jamesguitar3/sparkpal/(threads)

Thread 2 (2022-01-10):

Compiling error - fixed

gamemaster84, 2022-01-10:
Hi, When i compile i get an issue:

Arduino:1.8.15 (Windows 10), TD: 1.54, Board:"DOIT ESP32 DEVKIT V1, 80MHz, 921600, None"

sketch\sparkpal.ino.cpp.o:(.literal._Z6initBTv+0x14): undefined reference to `BluetoothSerial::register_callback(void (*)(esp_spp_cb_event_t, esp_spp_cb_param_t*))'

sketch\sparkpal.ino.cpp.o:(.literal._Z6initBTv+0x18): undefined reference to `BluetoothSerial::begin(String, bool)'

sketch\sparkpal.ino.cpp.o:(.literal.startup._GLOBAL__sub_I_SET_PRESET_1_CMD+0x24): undefined reference to `BluetoothSerial::BluetoothSerial()'

sketch\sparkpal.ino.cpp.o:(.literal._Z16sendSetPresetCmdPh+0x0): undefined reference to `BluetoothSerial::write(unsigned char const*, unsigned int)'

sketch\sparkpal.ino.cpp.o:(.literal._Z12connectToAmpv+0x14): undefined reference to `BluetoothSerial::connect(String)'

sketch\sparkpal.ino.cpp.o:(.literal._Z12connectToAmpv+0x18): undefined reference to `BluetoothSerial::hasClient()'

sketch\sparkpal.ino.cpp.o:(.literal._Z16processRecBTDatah+0x10): undefined reference to `BluetoothSerial::available()'

sketch\sparkpal.ino.cpp.o:(.literal._Z4loopv+0x0): undefined reference to `BluetoothSerial::read()'

sketch\sparkpal.ino.cpp.o:(.literal.exit._GLOBAL__sub_D_SET_PRESET_1_CMD+0x0): undefined reference to `BluetoothSerial::~BluetoothSerial()'

sketch\sparkpal.ino.cpp.o: In function `initBT()':

sparkpal/sparkpal.ino:224: undefined reference to `BluetoothSerial::register_callback(void (*)(esp_spp_cb_event_t, esp_spp_cb_param_t*))'

sparkpal/sparkpal.ino:225: undefined reference to `BluetoothSerial::begin(String, bool)'

sketch\sparkpal.ino.cpp.o: In function `_GLOBAL__sub_I_SET_PRESET_1_CMD':

\sparkpal/sparkpal.ino:31: undefined reference to `BluetoothSerial::BluetoothSerial()'

sketch\sparkpal.ino.cpp.o: In function `MatchState::MatchState()':

\Arduino\libraries\Regexp\src/Regexp.h:79: undefined reference to `BluetoothSerial::write(unsigned char const*, unsigned int)'

sketch\sparkpal.ino.cpp.o: In function `btnPresetHandler(BfButton*, BfButton::press_pattern_t)':

sparkpal/sparkpal.ino:114: undefined reference to `BluetoothSerial::write(unsigned char const*, unsigned int)'

sketch\sparkpal.ino.cpp.o: In function `sendFXOnOffCmd(int, int)':

sparkpal/sparkpal.ino:197: undefined reference to `BluetoothSerial::write(unsigned char const*, unsigned int)'

sketch\sparkpal.ino.cpp.o: In function `connectToAmp()':

sparkpal/sparkpal.ino:238: undefined reference to `BluetoothSerial::connect(String)'

sparkpal/sparkpal.ino:239: undefined reference to `BluetoothSerial::hasClient()'

sparkpal/sparkpal.ino:246: undefined reference to `BluetoothSerial::write(unsigned char const*, unsigned int)'

sketch\sparkpal.ino.cpp.o: In function `processRecBTData(unsigned char)':

sparkpal/sparkpal.ino:383: undefined reference to `BluetoothSerial::available()'

sparkpal/sparkpal.ino:429: undefined reference to `BluetoothSerial::write(unsigned char const*, unsigned int)'

sketch\sparkpal.ino.cpp.o: In function `loop()':

sparkpal/sparkpal.ino:479: undefined reference to `BluetoothSerial::available()'

sparkpal/sparkpal.ino:480: undefined reference to `BluetoothSerial::read()'

sketch\sparkpal.ino.cpp.o: In function `_GLOBAL__sub_D_SET_PRESET_1_CMD':

sparkpal/sparkpal.ino:483: undefined reference to `BluetoothSerial::~BluetoothSerial()'

collect2.exe: error: ld returned 1 exit status

exit status 1

Fout bij het compileren voor board DOIT ESP32 DEVKIT V1

Can you help out please?

Joost

Closed 2022-01-11.
