jamesguitar3/sparkpal/assets/SparkPal -esp32_wiring.pdf

## GND

## esp32

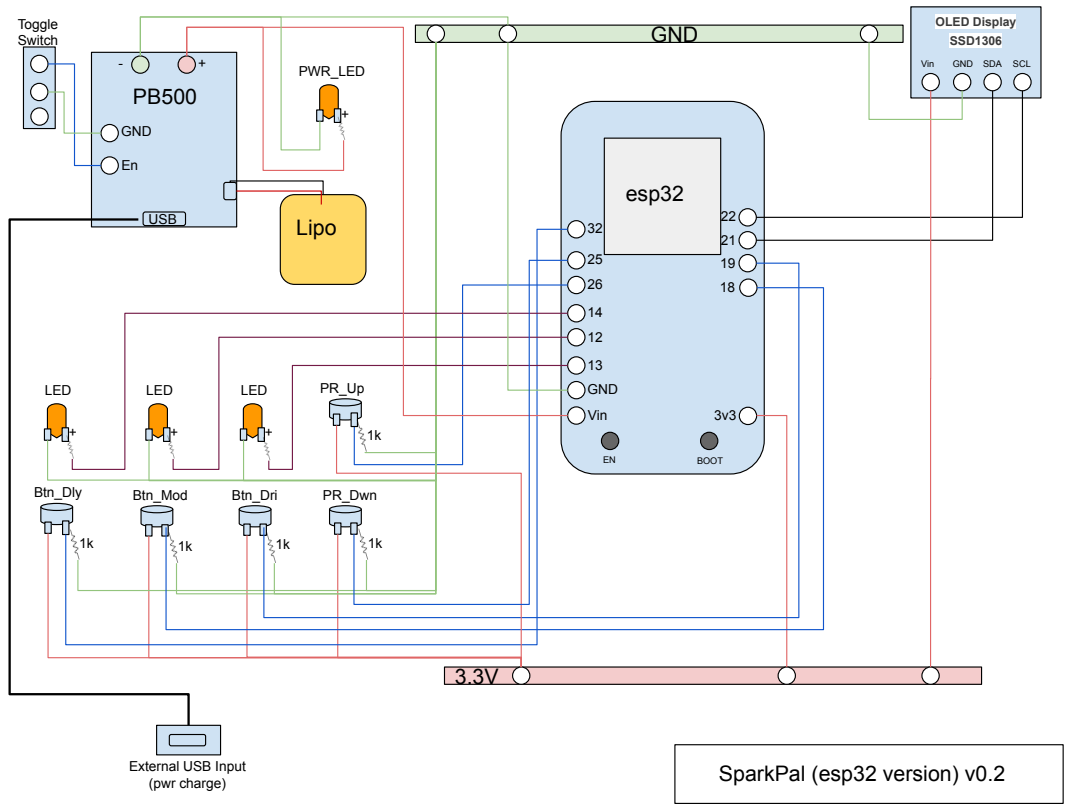
[picture p4: page 1]
BOOT; GND; Vin; GND SDA; SCL; OLED Display; SSD1306; Btn_Dly; Btn_Mod; Btn_Dri; PR_Dwn; LED; PWR_LED; Lipo; USB; Toggle Switch; SparkPal (esp32 version) v0.2

External USB Input
(pwr charge)
