jamesguitar3/sparkpal/(commit log)

2021-04-11 Added esp32 version and wiring schematic
2021-04-11 Added esp32 demo video
2021-04-12 Added LED resistor calculator link
